openstm32/Stm32_hw/MM4_r0/MM4_r0_board.jpg

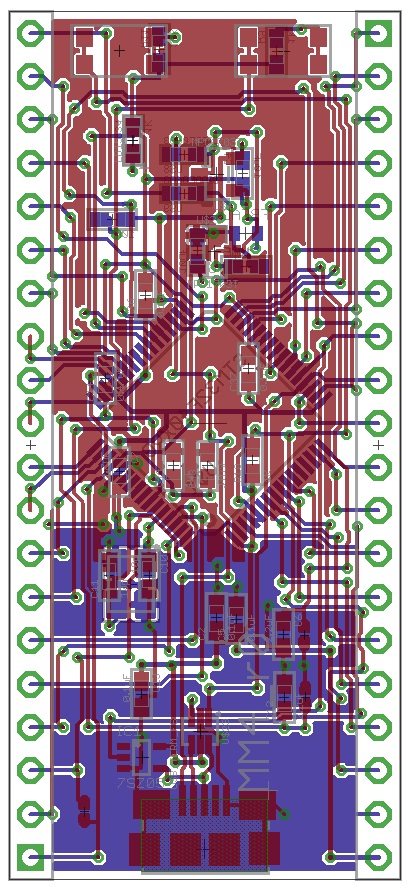
MM4_r0/MM4_r0_board.jpg
