openstm32/Stm32_hw/MM4_r0/MM4_r0_schematic.pdf

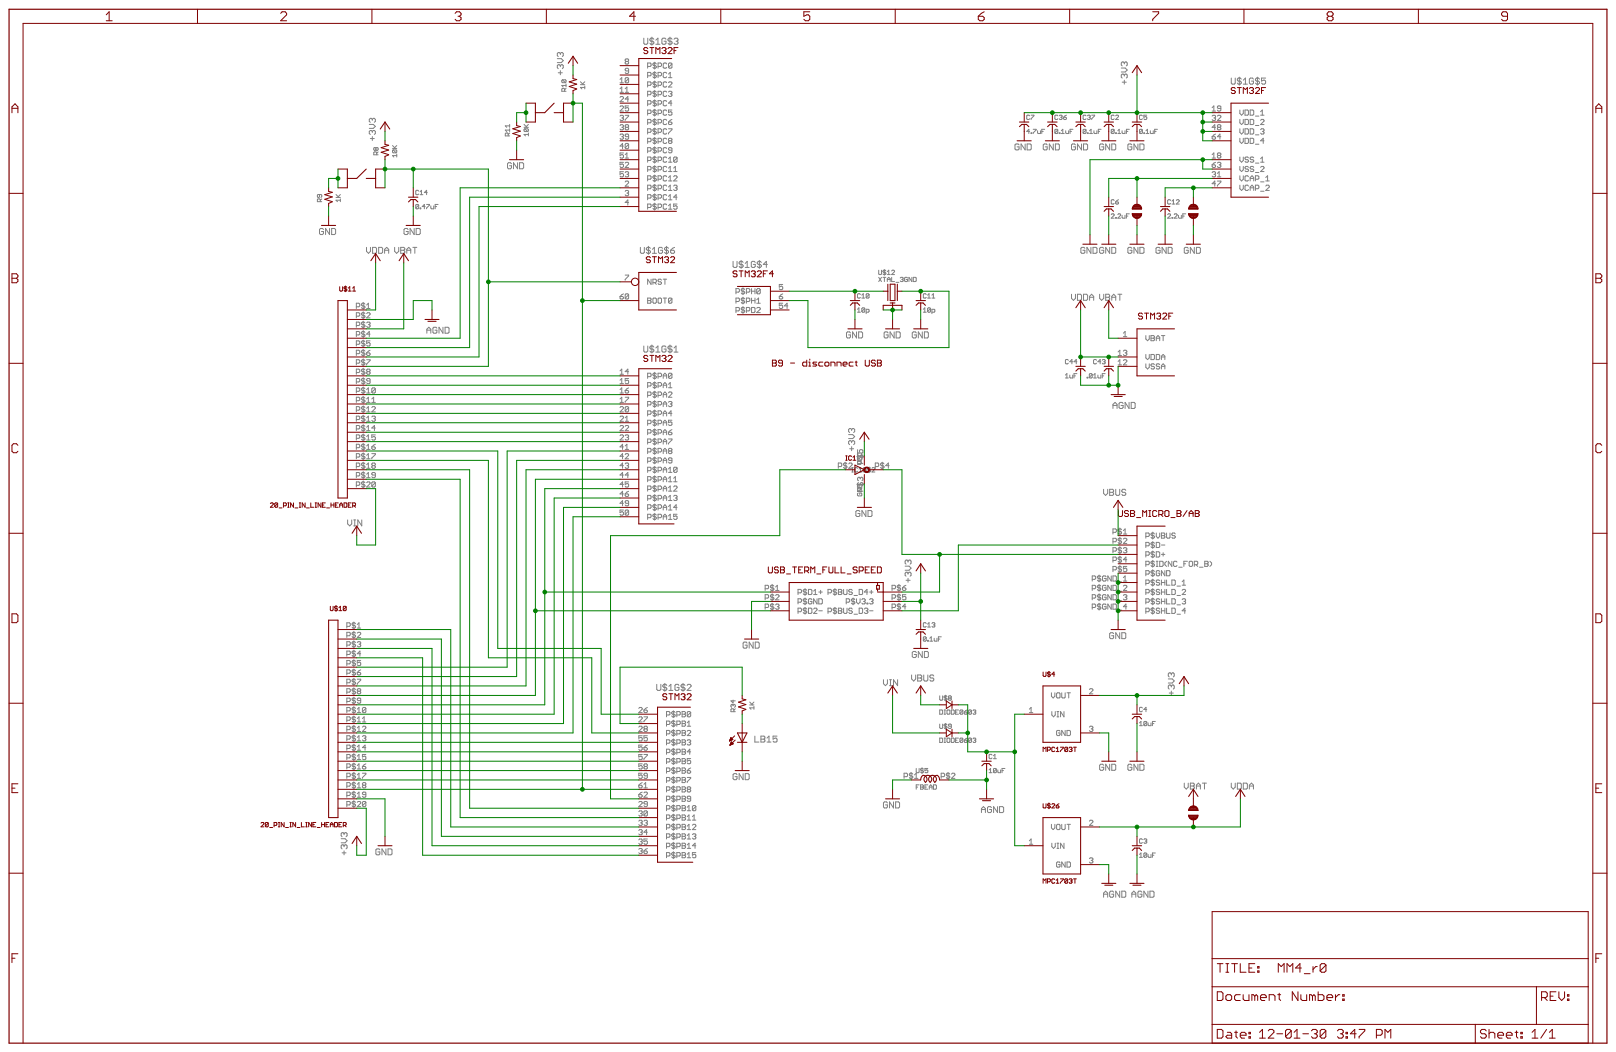
[picture p2: page 1]
